robincoxe/kegboard/hw/BeagleBeer/BeagleBeer-FAB/BeagleBeer_v2_BOM.txt

Partlist exported from c:/close-haul/github/kegboard/hw/BeagleBeer/BeagleBeer.sch at 4/12/2013 11:06:30 PM

Part         Value                        Device                       Package               Description                                        TP_SIGNAL_NAME
C1           0.1 uF                       CAP0805                      0805                  Capacitor                                                        
C2           0.1 uF                       CAP0805                      0805                  Capacitor                                                        
C3           0.1 uF                       CAP0805                      0805                  Capacitor                                                        
C4           0.1 uF                       CAP0805                      0805                  Capacitor                                                        
C5           0.1 uF                       CAP0805                      0805                  Capacitor                                                        
C6           0.1 uF                       CAP0805                      0805                  Capacitor                                                        
C7           0.1 uF                       CAP0805                      0805                  Capacitor                                                        
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
RJ1          RJ45-8PTH                    RJ45-8PTH                    RJ45-8                RJ45 Jack                                                        
RJ2          RJ45-8PTH                    RJ45-8PTH                    RJ45-8                RJ45 Jack                                                        
SG1          BUZZERPTH                    BUZZERPTH                    BUZZER-12MM           Buzzer 12mm                                                      
SW1                                       TAC_SWITCHPTH                TACTILE-PTH           Momentary Switch                                                 
TEST_A                                    JUMPER-2PTH                  1X02                  Jumper                                                           
TEST_B                                    JUMPER-2PTH                  1X02                  Jumper                                                           
TEST_C                                    JUMPER-2PTH                  1X02                  Jumper                                                           
TEST_D                                    JUMPER-2PTH                  1X02                  Jumper                                                           
TP2          TPTP18SQ                     TPTP18SQ                     TP18SQ                Test pad                                                         
U1           TEMPERATURE-SENSORUMAX8      TEMPERATURE-SENSORUMAX8      UMAX8                                                                                  
U2                                        TXB0108PWR                   TSSOP20               8-Bit Bi-Directional Level Shifter                               
U3                                        TXB0108PWR                   TSSOP20               8-Bit Bi-Directional Level Shifter                               
U4           CAT24C256WI-GT3              CAT24C256WI-GT3              SOIC127P600X175-8N                                                                     
U5           BEAGLEBONE_OUTLINEBEAGLEBEER BEAGLEBONE_OUTLINEBEAGLEBEER BEAGLEBEER_SHIELD     Should match A3 pinout - but not completely tested
