robincoxe/kegboard/hw/BeagleBeer/BeagleBeer.pdf

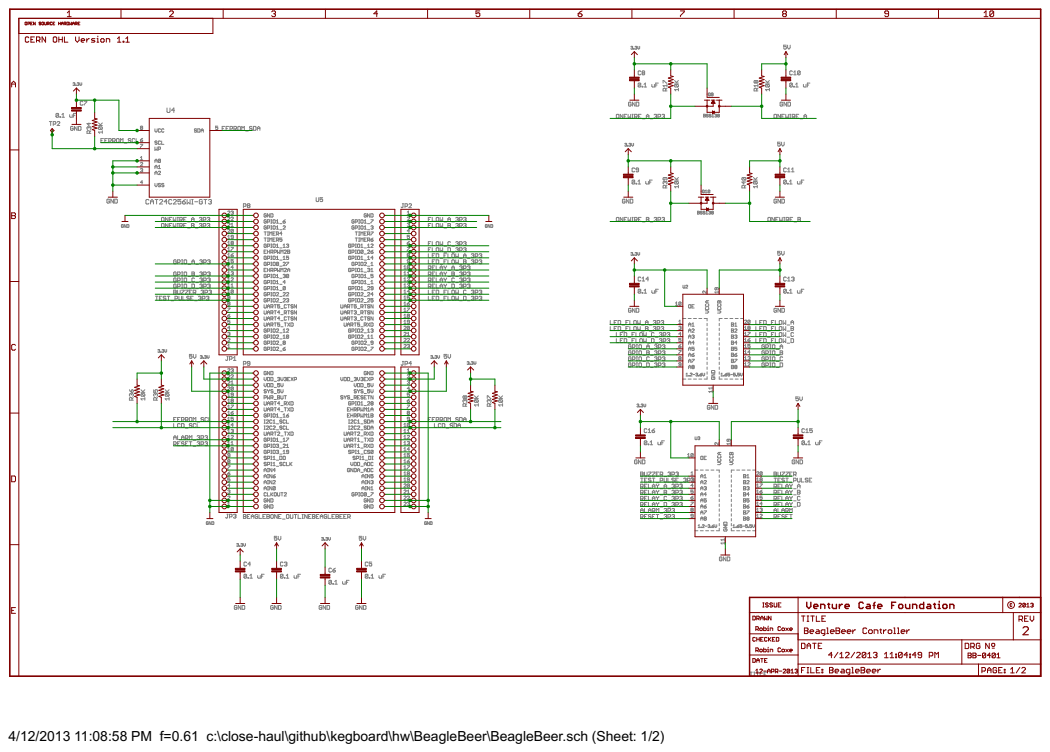
[picture p1: page 1]

4/12/2013 11:08:58 PM f=0.61 c:\close-haul\github\kegboard\hw\BeagleBeer\BeagleBeer.sch (Sheet: 1/2)

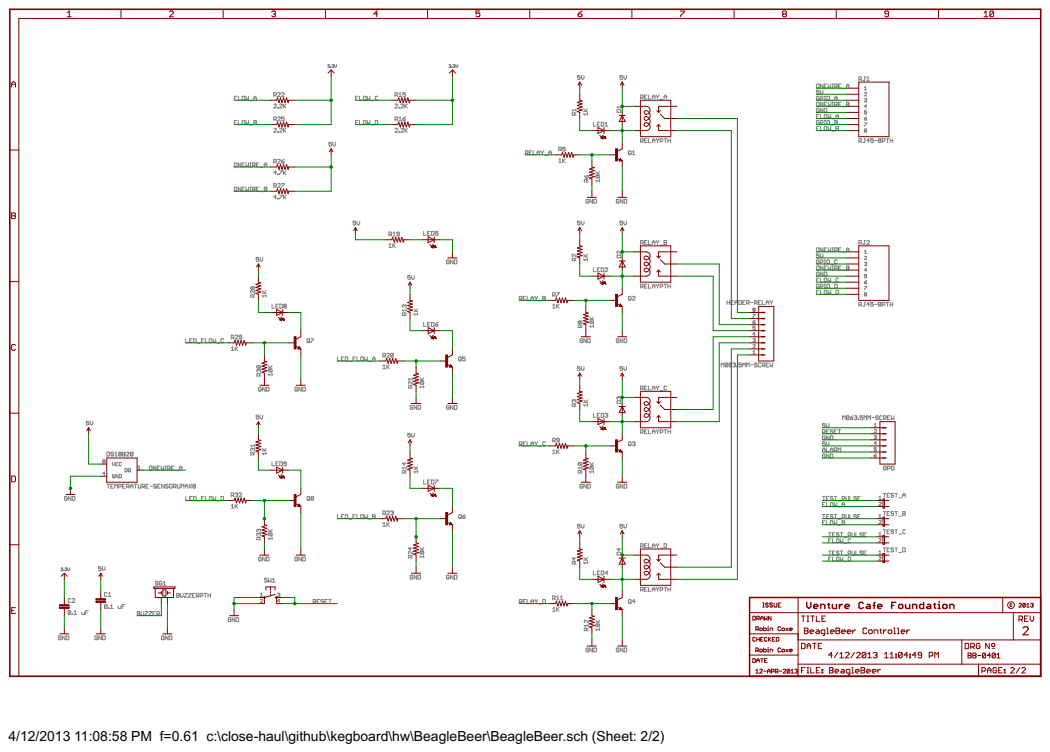
[picture p2: page 2]

4/12/2013 11:08:58 PM f=0.61 c:\close-haul\github\kegboard\hw\BeagleBeer\BeagleBeer.sch (Sheet: 2/2)
