robincoxe/kegboard/(list of files, drawings)

Other design files:
hw/BeagleBeer/BeagleBeer.dsn
hw/kegboard-coaster/kegboard-coaster-v2/kegboard-coaster.dsn
