robincoxe/kegboard/hw/kegboard-mini/kegboard-mini.brd

## EAGLE design hw/kegboard-mini/kegboard-mini.brd (2014-03-22)

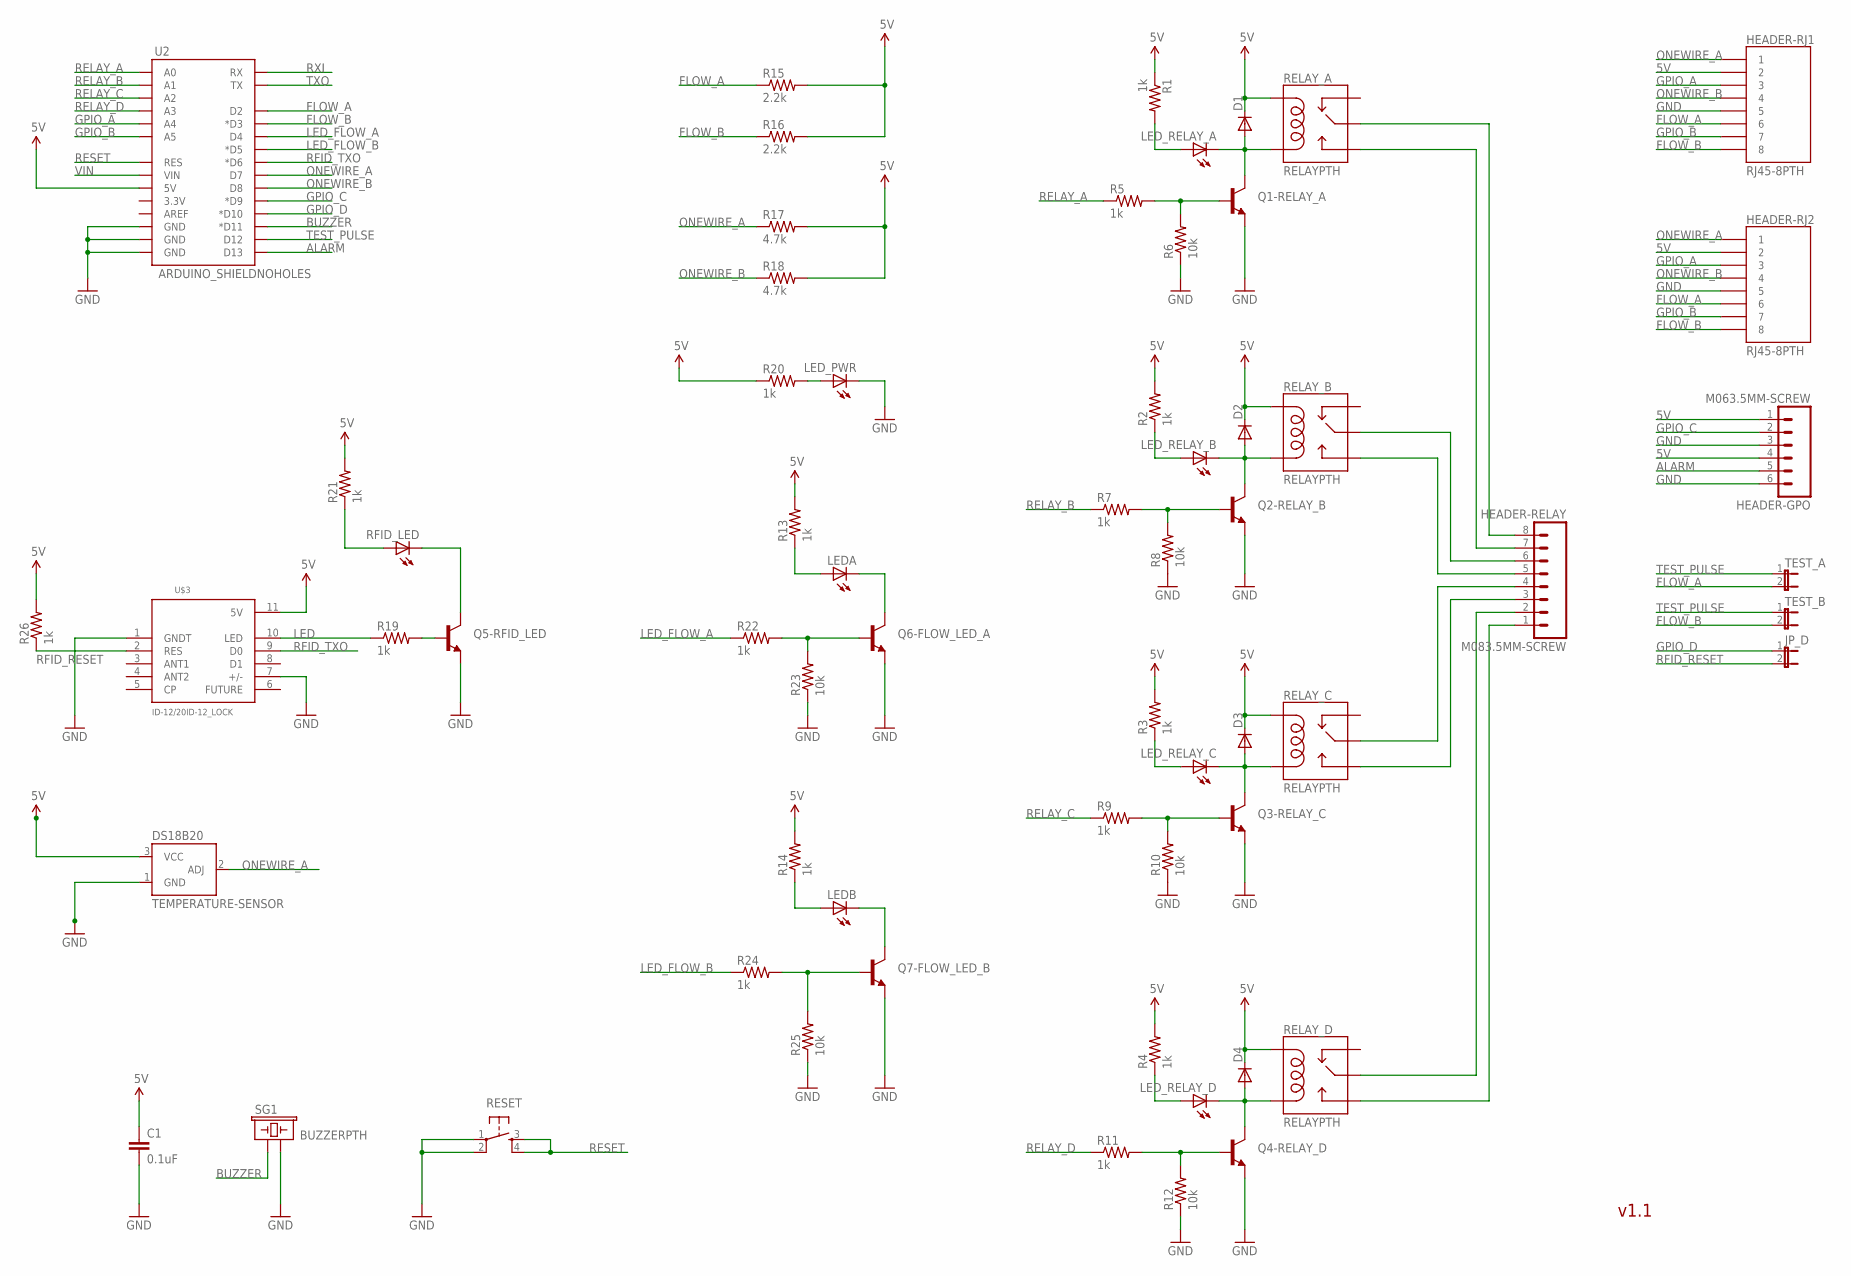
[picture p3: schematic kegboard-mini.sch]

Parts:
C1: 0.1uF; CAP-PTH-SMALL
D1, D2, D3, D4: DIODE1N4148; DIODE-1N4148
DS18B20: TEMPERATURE-SENSOR; TO-92
HEADER-GPO: M063.5MM-SCREW; SCREWTERMINAL-3.5MM-6
HEADER-RELAY: M083.5MM-SCREW; SCREWTERMINAL-3.5MM-8
HEADER-RJ1, HEADER-RJ2: RJ45-8PTH; RJ45-8
JP_D: JUMPER-2PTH; 1X02
LEDA: LED3MM
LEDB: LED3MM
LED_PWR: LED3MM
LED_RELAY_A: LED3MM
LED_RELAY_B: LED3MM
LED_RELAY_C: LED3MM
LED_RELAY_D: LED3MM
Q1-RELAY_A, Q2-RELAY_B, Q3-RELAY_C, Q4-RELAY_D, Q5-RFID_LED, Q6-FLOW_LED_A, Q7-FLOW_LED_B: TRANSISTOR_NPNTO92; TO-92
R1, R2, R3, R4, R5, R7, R9, R11, R13, R14, R19, R20, R21, R22, R24, R26: 1k; AXIAL-0.3
R6, R8, R10, R12, R23, R25: 10k; AXIAL-0.3
R15, R16: 2.2k; AXIAL-0.3
R17, R18: 4.7k; AXIAL-0.3
RELAY_A: RELAYPTH; RELAY-G5Q
RELAY_B: RELAYPTH; RELAY-G5Q
RELAY_C: RELAYPTH; RELAY-G5Q
RELAY_D: RELAYPTH; RELAY-G5Q
RESET: TAC_SWITCHPTH; TACTILE-PTH
RFID_LED: LED3MM
SG1: BUZZERPTH; BUZZER-12MM
TEST_A: JUMPER-2PTH; 1X02
TEST_B: JUMPER-2PTH; 1X02
U2: ARDUINO_SHIELDNOHOLES; DUEMILANOVE_SHIELD_NOHOLES
U$3: ID-12/20ID-12_LOCK; ID-12_LOCK

Connections:
5V: C1.1, D1.C, D2.C, D3.C, D4.C, DS18B20.3 (VCC), HEADER-GPO.1, HEADER-GPO.4, HEADER-RJ1.2, HEADER-RJ2.2, R1.P$1 (1), R2.P$2 (2), R3.P$2 (2), R4.P$2 (2), R13.P$2 (2), R14.P$2 (2), R15.P$2 (2), R16.P$2 (2), R17.P$2 (2), R18.P$2 (2), R20.P$1 (1), R21.P$2 (2), R26.P$2 (2), RELAY_A.5 (COIL1), RELAY_B.5 (COIL1), RELAY_C.5 (COIL1), RELAY_D.5 (COIL1), U2.5V, U$3.11 (5V)
ALARM: HEADER-GPO.5, U2.D13
BUZZER: SG1.+ (1), U2.D11 (*D11)
FLOW_A: HEADER-RJ1.6, HEADER-RJ2.6, R15.P$1 (1), TEST_A.2, U2.D2
FLOW_B: HEADER-RJ1.8, HEADER-RJ2.8, R16.P$1 (1), TEST_B.2, U2.D3 (*D3)
GND: C1.2, DS18B20.1 (GND), HEADER-GPO.3, HEADER-GPO.6, HEADER-RJ1.5, HEADER-RJ2.5, LED_PWR.K (C), Q1-RELAY_A.1 (E), Q2-RELAY_B.1 (E), Q3-RELAY_C.1 (E), Q4-RELAY_D.1 (E), Q5-RFID_LED.1 (E), Q6-FLOW_LED_A.1 (E), Q7-FLOW_LED_B.1 (E), R6.P$1 (1), R8.P$1 (1), R10.P$1 (1), R12.P$1 (1), R23.P$1 (1), R25.P$1 (1), RESET.1, RESET.2, SG1.- (2), U2.GND@0 (GND), U2.GND@1 (GND), U2.GND@2 (GND), U$3.1 (GNDT), U$3.7 (+/-)
GPIO_A: HEADER-RJ1.3, HEADER-RJ2.3, U2.A4
GPIO_B: HEADER-RJ1.7, HEADER-RJ2.7, U2.A5
GPIO_C: HEADER-GPO.2, U2.D9 (*D9)
GPIO_D: JP_D.1, U2.D10 (*D10)
LED: R19.P$1 (1), U$3.10 (LED)
LED_FLOW_A: R22.P$1 (1), U2.D4
LED_FLOW_B: R24.P$1 (1), U2.D5 (*D5)
unnamed: LED_RELAY_A.A, R1.P$2 (2)
unnamed: Q2-RELAY_B.2 (B), R7.P$2 (2), R8.P$2 (2)
unnamed: Q1-RELAY_A.2 (B), R5.P$2 (2), R6.P$2 (2)
unnamed: Q3-RELAY_C.2 (B), R9.P$2 (2), R10.P$2 (2)
unnamed: LED_RELAY_C.A, R3.P$1 (1)
unnamed: Q4-RELAY_D.2 (B), R11.P$2 (2), R12.P$2 (2)
unnamed: LED_RELAY_B.A, R2.P$1 (1)
unnamed: LEDB.K (C), Q7-FLOW_LED_B.3 (C)
unnamed: LEDA.K (C), Q6-FLOW_LED_A.3 (C)
unnamed: D1.A, LED_RELAY_A.K (C), Q1-RELAY_A.3 (C), RELAY_A.1 (COIL2)
unnamed: LED_RELAY_D.A, R4.P$1 (1)
unnamed: D2.A, LED_RELAY_B.K (C), Q2-RELAY_B.3 (C), RELAY_B.1 (COIL2)
unnamed: LED_PWR.A, R20.P$2 (2)
unnamed: D3.A, LED_RELAY_C.K (C), Q3-RELAY_C.3 (C), RELAY_C.1 (COIL2)
unnamed: HEADER-RELAY.8, RELAY_A.2 (MAIN)
unnamed: D4.A, LED_RELAY_D.K (C), Q4-RELAY_D.3 (C), RELAY_D.1 (COIL2)
unnamed: Q5-RFID_LED.2 (B), R19.P$2 (2)
unnamed: R21.P$1 (1), RFID_LED.A
unnamed: Q5-RFID_LED.3 (C), RFID_LED.K (C)
unnamed: HEADER-RELAY.7, RELAY_A.3 (NO)
unnamed: HEADER-RELAY.6, RELAY_B.2 (MAIN)
unnamed: HEADER-RELAY.5, RELAY_B.3 (NO)
unnamed: HEADER-RELAY.4, RELAY_C.2 (MAIN)
unnamed: LEDA.A, R13.P$1 (1)
unnamed: HEADER-RELAY.3, RELAY_C.3 (NO)
unnamed: HEADER-RELAY.2, RELAY_D.2 (MAIN)
unnamed: HEADER-RELAY.1, RELAY_D.3 (NO)
unnamed: LEDB.A, R14.P$1 (1)
unnamed: Q6-FLOW_LED_A.2 (B), R22.P$2 (2), R23.P$2 (2)
unnamed: Q7-FLOW_LED_B.2 (B), R24.P$2 (2), R25.P$2 (2)
ONEWIRE_A: DS18B20.2 (ADJ), HEADER-RJ1.1, HEADER-RJ2.1, R17.P$1 (1), U2.D7
ONEWIRE_B: HEADER-RJ1.4, HEADER-RJ2.4, R18.P$1 (1), U2.D8
RELAY_A: R5.P$1 (1), U2.A0
RELAY_B: R7.P$1 (1), U2.A1
RELAY_C: R9.P$1 (1), U2.A2
RELAY_D: R11.P$1 (1), U2.A3
RESET: RESET.3, RESET.4, U2.RES
RFID_RESET: JP_D.2, R26.P$1 (1), U$3.2 (RES)
RFID_TXO: U2.D6 (*D6), U$3.9 (D0)
RXI: U2.RX
TEST_PULSE: TEST_A.1, TEST_B.1, U2.D12
TXO: U2.TX
VIN: U2.VIN

Notes on the sheet:
v1.1

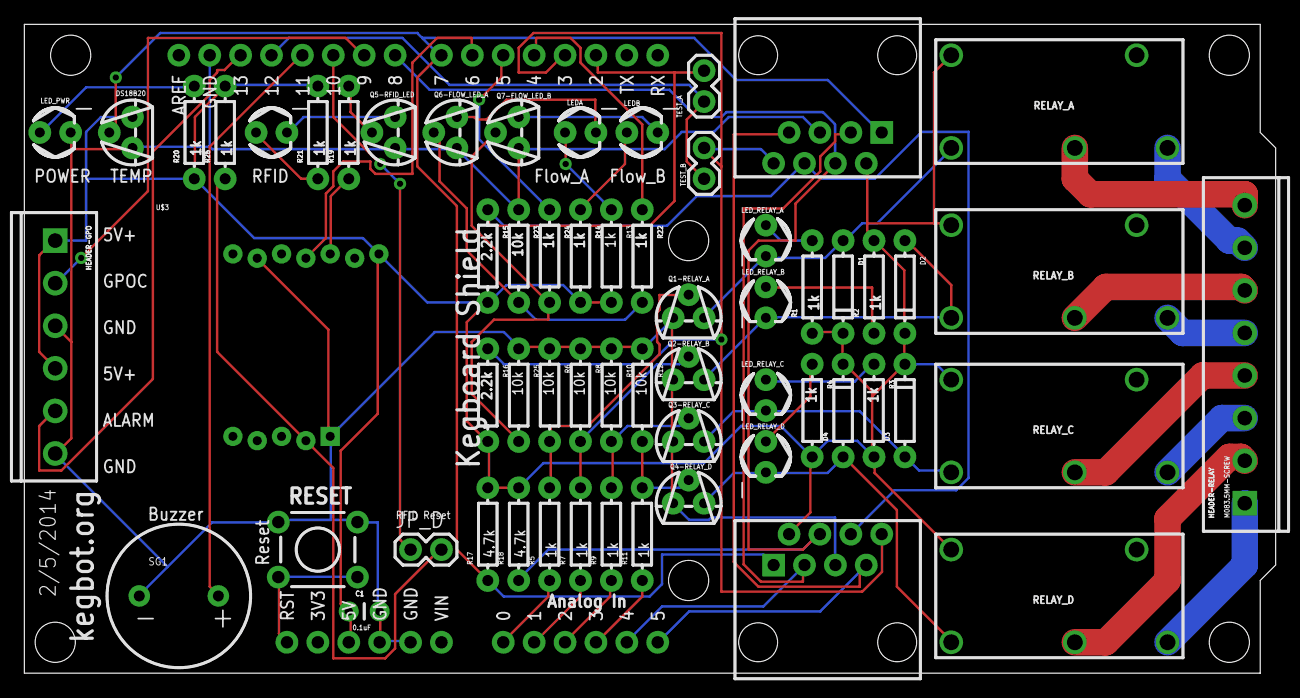
[picture p4: board kegboard-mini.brd from above]

Board: 2 copper layers, 102.9 x 53.3 mm, 68 parts (0 on the bottom side), 53 nets.

Other parts of the board:
JP1, JP2, JP3, JP4, JP5, JP6: STAND-OFF
