robincoxe/kegboard/hw/kegboard-coaster-alt/kegboard-coaster-alt.brd

## EAGLE design hw/kegboard-coaster-alt/kegboard-coaster-alt.brd (2013-07-20)

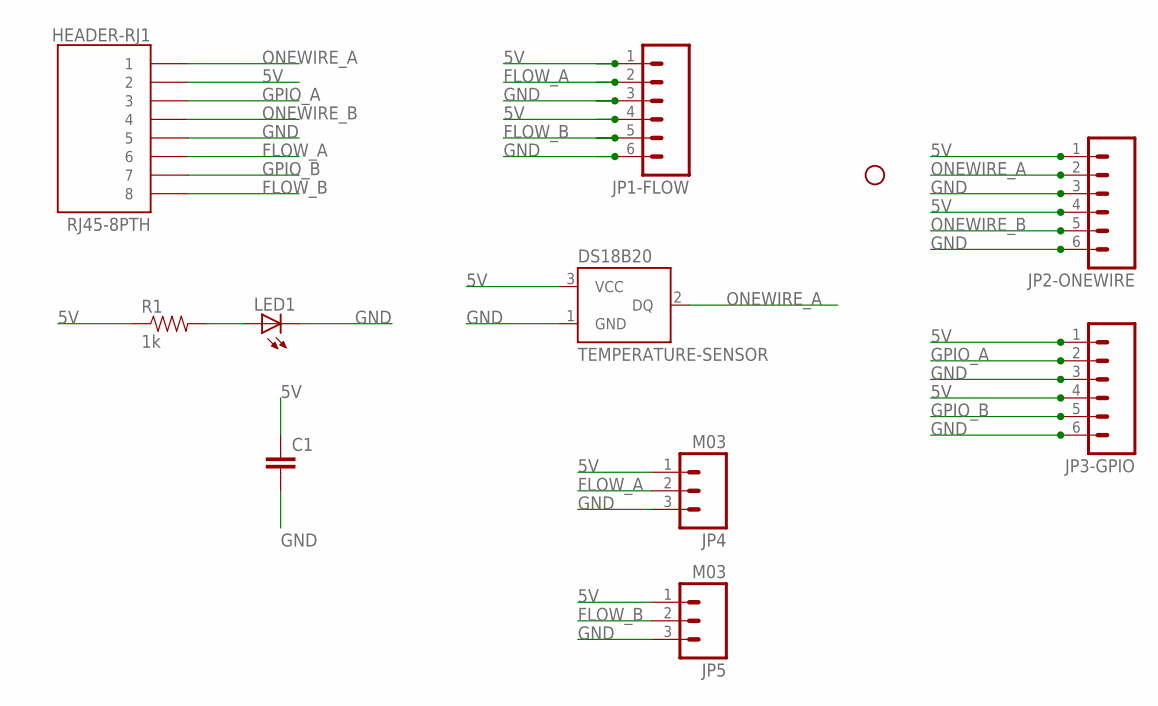
[picture p5: schematic kegboard-coaster-alt.sch]

Parts:
C1: CAPPTH2; CAP-PTH-SMALL2
HEADER-RJ1: RJ45-8PTH; RJ45-8
JP1-FLOW, JP2-ONEWIRE, JP3-GPIO: M063.5MM-6; SCREWTERMINAL-3.5MM-6
JP2: STAND-OFF
JP4, JP5: M03; 53324-0360
LED1: LED3MM
R1: 1k; AXIAL-0.3
U$1: TEMPERATURE-SENSOR; TO-92

Connections:
5V: C1.1, HEADER-RJ1.2, JP1-FLOW.1, JP1-FLOW.4, JP2-ONEWIRE.1, JP2-ONEWIRE.4, JP3-GPIO.1, JP3-GPIO.4, JP4.1, JP5.1, R1.P$1 (1), U$1.3 (VCC)
FLOW_A: HEADER-RJ1.6, JP1-FLOW.2, JP4.2
FLOW_B: HEADER-RJ1.8, JP1-FLOW.5, JP5.2
GND: C1.2, HEADER-RJ1.5, JP1-FLOW.3, JP1-FLOW.6, JP2-ONEWIRE.3, JP2-ONEWIRE.6, JP3-GPIO.3, JP3-GPIO.6, JP4.3, JP5.3, LED1.K (C), U$1.1 (GND)
GPIO_A: HEADER-RJ1.3, JP3-GPIO.2
GPIO_B: HEADER-RJ1.7, JP3-GPIO.5
unnamed: LED1.A, R1.P$2 (2)
ONEWIRE_A: HEADER-RJ1.1, JP2-ONEWIRE.2, U$1.2 (DQ)
ONEWIRE_B: HEADER-RJ1.4, JP2-ONEWIRE.5

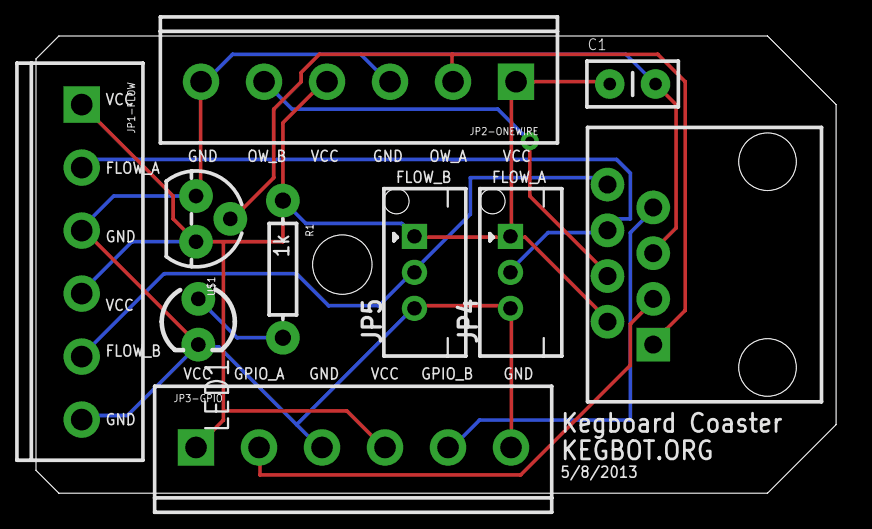
[picture p6: board kegboard-coaster-alt.brd from above]

Board: 2 copper layers, 44.5 x 25.4 mm, 11 parts (0 on the bottom side), 9 nets.
