robincoxe/kegboard/hw/BeagleBeer/BeagleBeer.brd

## EAGLE design hw/BeagleBeer/BeagleBeer.brd (2013-05-08)

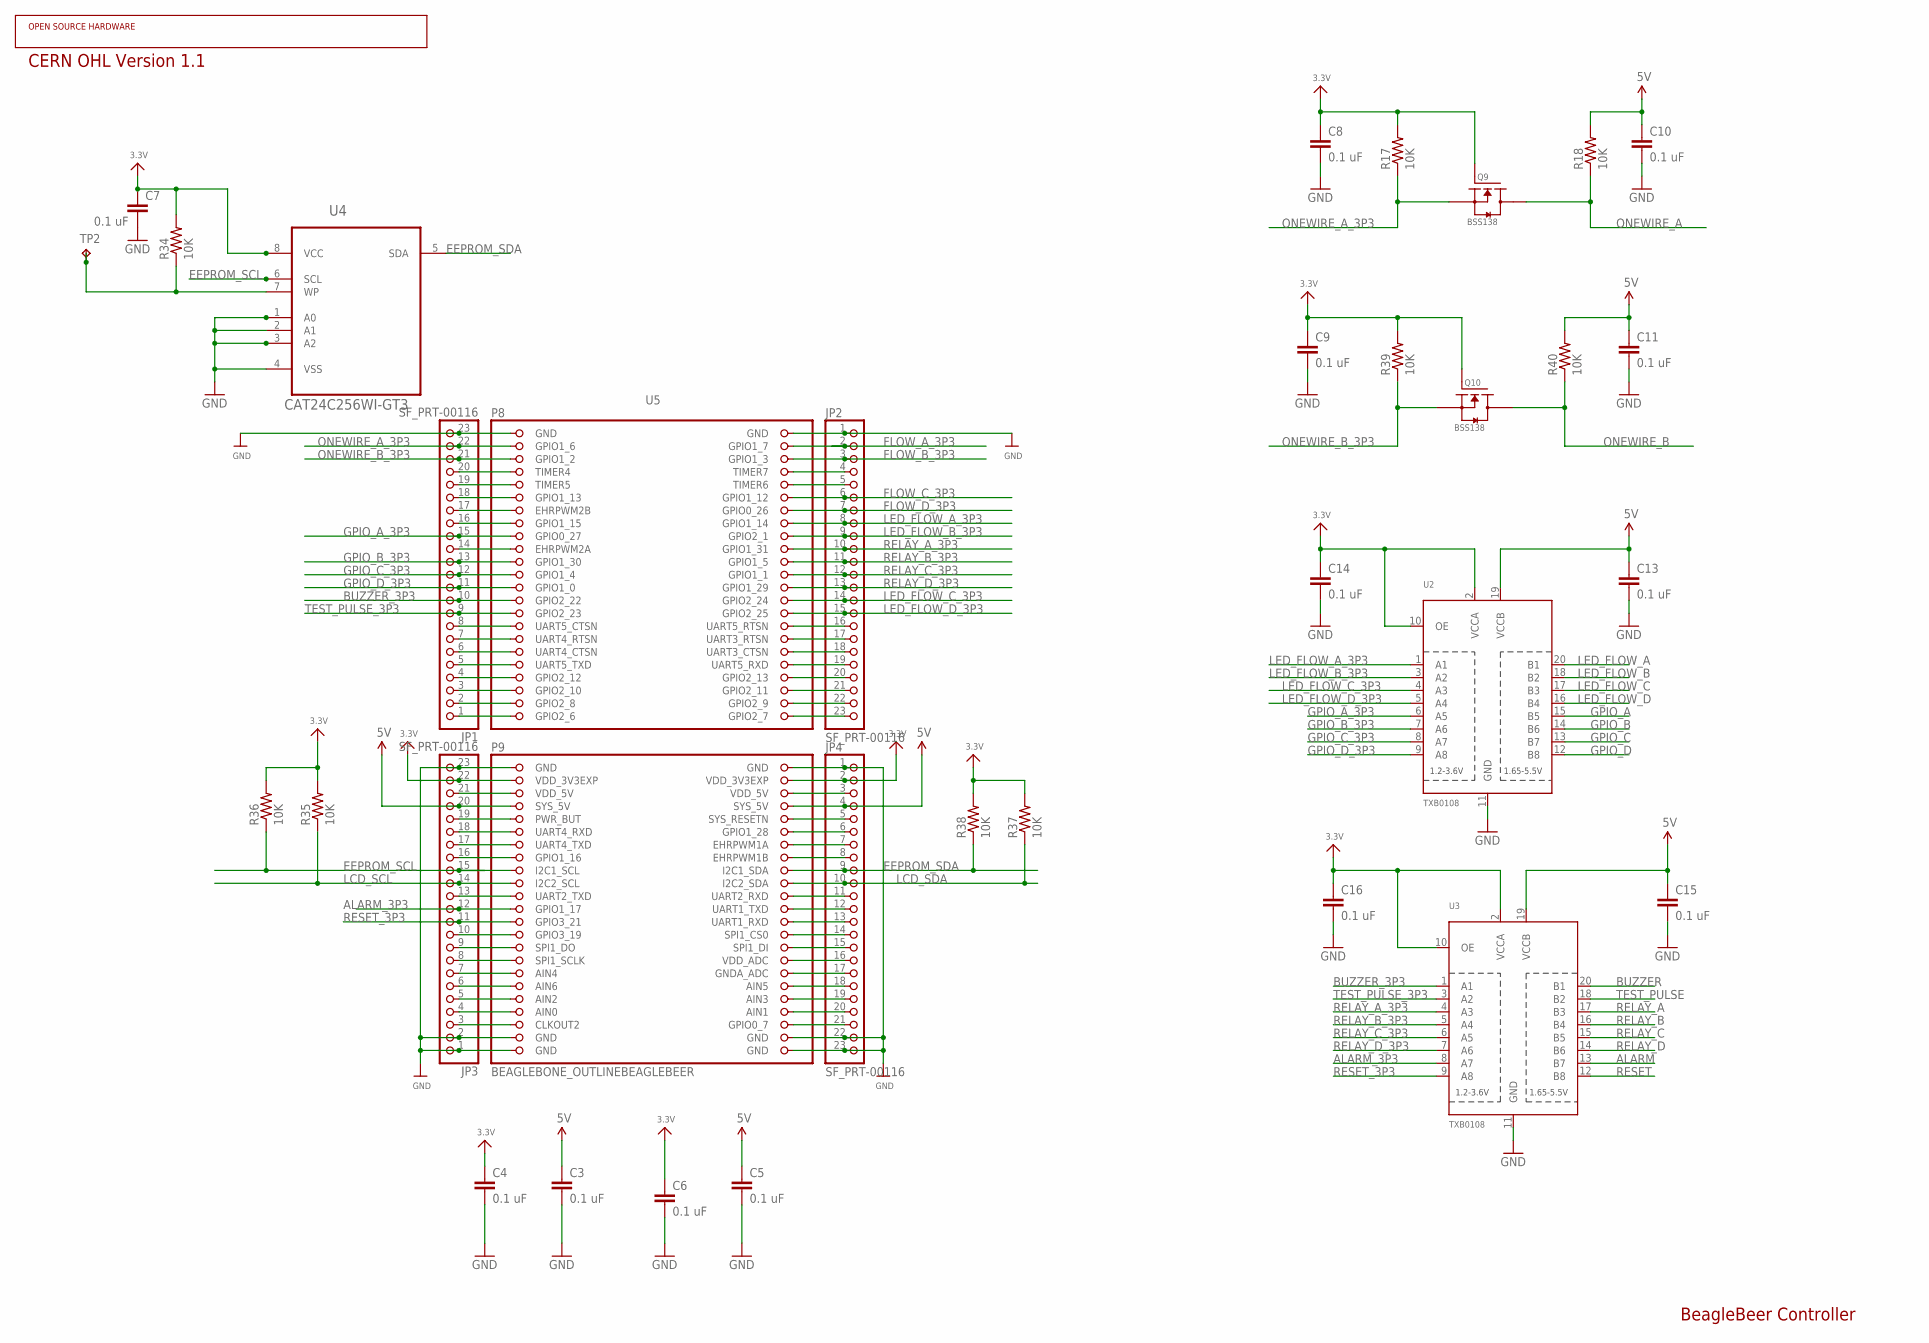
[picture p7: schematic BeagleBeer.sch, sheet 1]

Parts:
C3, C4, C5, C6, C7, C8, C9, C10, C11, C13, C14, C15, C16: 0.1 uF; 0805
JP1, JP2, JP3, JP4: SF_PRT-00116; 1X23_ROUND_70MIL
Q9, Q10: BSS138; SOT323
R17, R18, R34, R35, R36, R37, R38, R39, R40: 10K; 0805
TP2: TPTP18SQ; TP18SQ
U2, U3: TXB0108; TSSOP20
U4: CAT24C256WI-GT3; SOIC127P600X175-8N
U5: BEAGLEBONE_OUTLINEBEAGLEBEER; BEAGLEBEER_SHIELD

Connections:
3.3V: C4.1, C6.1, C7.1, C8.1, C9.1, C14.1, C16.1, JP3.22, JP4.2, Q9.1 (G), Q10.1 (G), R17.2, R34.2, R35.2, R36.2, R37.2, R38.2, R39.2, U2.2 (VCCA), U2.10 (OE), U3.2 (VCCA), U3.10 (OE), U4.8 (VCC), U5.49 (VDD_3V3EXP), U5.50 (VDD_3V3EXP); also elsewhere on the board
5V: C3.1, C5.1, C10.1, C11.1, C13.1, C15.1, JP3.20, JP4.4, R18.2, R40.2, U2.19 (VCCB), U3.19 (VCCB), U5.53 (SYS_5V), U5.54 (SYS_5V); also elsewhere on the board
ALARM: U3.13 (B7); also elsewhere on the board
ALARM_3P3: JP3.12, U3.8 (A7), U5.69 (GPIO1_17)
BUZZER: U3.20 (B1); also elsewhere on the board
BUZZER_3P3: JP1.10, U3.1 (A1), U5.27 (GPIO2_22)
EEPROM_SCL: JP3.15, R36.1, U4.6 (SCL), U5.63 (I2C1_SCL)
EEPROM_SDA: JP4.9, R38.1, U4.5 (SDA), U5.64 (I2C1_SDA)
FLOW_A_3P3: JP2.2, U5.4 (GPIO1_7)
FLOW_B_3P3: JP2.3, U5.6 (GPIO1_3)
FLOW_C_3P3: JP2.6, U5.12 (GPIO1_12)
FLOW_D_3P3: JP2.7, U5.14 (GPIO0_26)
GND: C3.2, C4.2, C5.2, C6.2, C7.2, C8.2, C9.2, C10.2, C11.2, C13.2, C14.2, C15.2, C16.2, JP1.23, JP2.1, JP3.1, JP3.2, JP3.23, JP4.1, JP4.22, JP4.23, U2.11 (GND), U3.11 (GND), U4.1 (A0), U4.2 (A1), U4.3 (A2), U4.4 (VSS), U5.1 (GND), U5.2 (GND), U5.47 (GND), U5.48 (GND), U5.89 (GND), U5.90 (GND), U5.91 (GND), U5.92 (GND); also elsewhere on the board
GPIO_A: U2.15 (B5); also elsewhere on the board
GPIO_A_3P3: JP1.15, U2.6 (A5), U5.17 (GPIO0_27)
GPIO_B: U2.14 (B6); also elsewhere on the board
GPIO_B_3P3: JP1.13, U2.7 (A6), U5.21 (GPIO1_30)
GPIO_C: U2.13 (B7); also elsewhere on the board
GPIO_C_3P3: JP1.12, U2.8 (A7), U5.23 (GPIO1_4)
GPIO_D: U2.12 (B8); also elsewhere on the board
GPIO_D_3P3: JP1.11, U2.9 (A8), U5.25 (GPIO1_0)
LCD_SCL: JP3.14, R35.1, U5.65 (I2C2_SCL)
LCD_SDA: JP4.10, R37.1, U5.66 (I2C2_SDA)
LED_FLOW_A: U2.20 (B1); also elsewhere on the board
LED_FLOW_A_3P3: JP2.8, U2.1 (A1), U5.16 (GPIO1_14)
LED_FLOW_B: U2.18 (B2); also elsewhere on the board
LED_FLOW_B_3P3: JP2.9, U2.3 (A2), U5.18 (GPIO2_1)
LED_FLOW_C: U2.17 (B3); also elsewhere on the board
LED_FLOW_C_3P3: JP2.14, U2.4 (A3), U5.28 (GPIO2_24)
LED_FLOW_D: U2.16 (B4); also elsewhere on the board
LED_FLOW_D_3P3: JP2.15, U2.5 (A4), U5.30 (GPIO2_25)
unnamed: JP1.2, U5.43 (GPIO2_8)
unnamed: JP1.1, U5.45 (GPIO2_6)
unnamed: JP1.20, U5.7 (TIMER4)
unnamed: JP1.19, U5.9 (TIMER5)
unnamed: JP2.16, U5.32 (UART5_RTSN)
unnamed: JP1.17, U5.13 (EHRPWM2B)
unnamed: JP2.17, U5.34 (UART3_RTSN)
unnamed: JP2.18, U5.36 (UART3_CTSN)
unnamed: JP1.14, U5.19 (EHRPWM2A)
unnamed: JP2.19, U5.38 (UART5_RXD)
unnamed: JP2.20, U5.40 (GPIO2_13)
unnamed: JP2.21, U5.42 (GPIO2_11)
unnamed: JP2.22, U5.44 (GPIO2_9)
unnamed: JP2.23, U5.46 (GPIO2_7)
unnamed: JP1.8, U5.31 (UART5_CTSN)
unnamed: JP1.7, U5.33 (UART4_RTSN)
unnamed: JP1.6, U5.35 (UART4_CTSN)
unnamed: JP1.5, U5.37 (UART5_TXD)
unnamed: JP1.4, U5.39 (GPIO2_12)
unnamed: JP1.3, U5.41 (GPIO2_10)
unnamed: JP2.4, U5.8 (TIMER7)
unnamed: JP2.5, U5.10 (TIMER6)
unnamed: JP3.21, U5.51 (VDD_5V)
unnamed: JP3.19, U5.55 (PWR_BUT)
unnamed: JP3.18, U5.57 (UART4_RXD)
unnamed: JP3.17, U5.59 (UART4_TXD)
unnamed: JP3.16, U5.61 (GPIO1_16)
unnamed: JP3.13, U5.67 (UART2_TXD)
unnamed: JP3.10, U5.73 (GPIO3_19)
unnamed: JP3.9, U5.75 (SPI1_DO)
unnamed: JP3.8, U5.77 (SPI1_SCLK)
unnamed: JP3.7, U5.79 (AIN4)
unnamed: JP3.6, U5.81 (AIN6)
unnamed: JP3.5, U5.83 (AIN2)
unnamed: JP3.4, U5.85 (AIN0)
unnamed: JP3.3, U5.87 (CLKOUT2)
unnamed: JP4.21, U5.88 (GPIO0_7)
unnamed: JP4.3, U5.52 (VDD_5V)
unnamed: JP4.5, U5.56 (SYS_RESETN)
unnamed: JP4.6, U5.58 (GPIO1_28)
unnamed: JP4.7, U5.60 (EHRPWM1A)
unnamed: JP4.8, U5.62 (EHRPWM1B)
unnamed: JP4.11, U5.68 (UART2_RXD)
unnamed: JP4.12, U5.70 (UART1_TXD)
unnamed: JP4.13, U5.72 (UART1_RXD)
unnamed: JP4.14, U5.74 (SPI1_CS0)
unnamed: JP4.15, U5.76 (SPI1_DI)
unnamed: JP4.16, U5.78 (VDD_ADC)
unnamed: JP4.17, U5.80 (GNDA_ADC)
unnamed: JP4.18, U5.82 (AIN5)
unnamed: JP4.19, U5.84 (AIN3)
unnamed: JP4.20, U5.86 (AIN1)
unnamed: R34.1, TP2.TP, U4.7 (WP)
ONEWIRE_A: Q9.3 (D1), R18.1; also elsewhere on the board
ONEWIRE_A_3P3: JP1.22, Q9.2 (S), R17.1, U5.3 (GPIO1_6)
ONEWIRE_B: Q10.3 (D1), R40.1; also elsewhere on the board
ONEWIRE_B_3P3: JP1.21, Q10.2 (S), R39.1, U5.5 (GPIO1_2)
ONEWIRE_C_3P3: JP1.18, U5.11 (GPIO1_13)
ONEWIRE_D_3P3: JP1.16, U5.15 (GPIO1_15)
RELAY_A: U3.17 (B3); also elsewhere on the board
RELAY_A_3P3: JP2.10, U3.4 (A3), U5.20 (GPIO1_31)
RELAY_B: U3.16 (B4); also elsewhere on the board
RELAY_B_3P3: JP2.11, U3.5 (A4), U5.22 (GPIO1_5)
RELAY_C: U3.15 (B5); also elsewhere on the board
RELAY_C_3P3: JP2.12, U3.6 (A5), U5.24 (GPIO1_1)
RELAY_D: U3.14 (B6); also elsewhere on the board
RELAY_D_3P3: JP2.13, U3.7 (A6), U5.26 (GPIO1_29)
RESET: U3.12 (B8); also elsewhere on the board
RESET_3P3: JP3.11, U3.9 (A8), U5.71 (GPIO3_21)
TEST_PULSE: U3.18 (B2); also elsewhere on the board
TEST_PULSE_3P3: JP1.9, U3.3 (A2), U5.29 (GPIO2_23)

Notes on the sheet:
BeagleBeer Controller

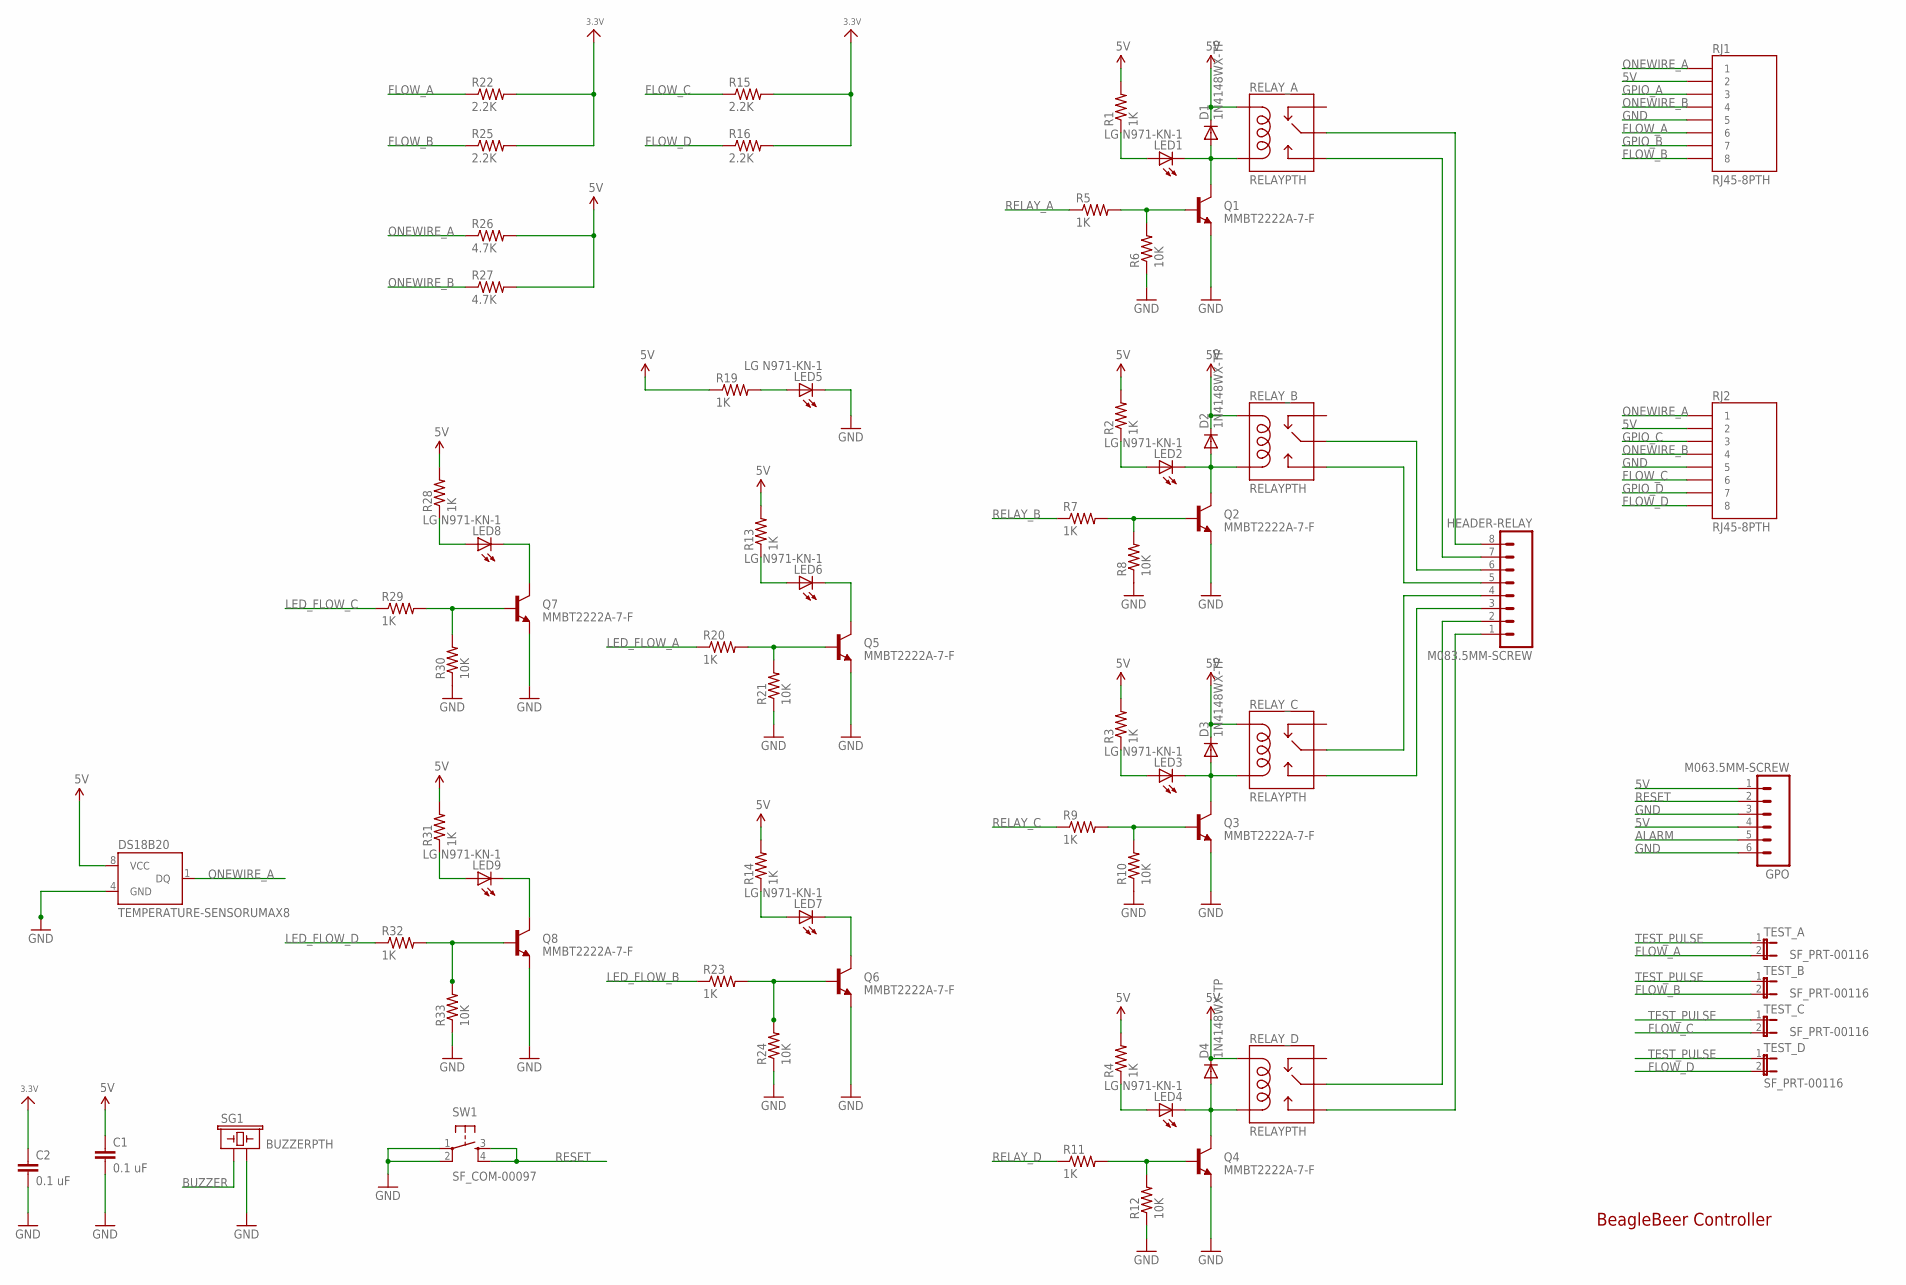
[picture p8: schematic BeagleBeer.sch, sheet 2]

Parts:
C1, C2: 0.1 uF; 0805
D1, D2, D3, D4: 1N4148WX-TP; SOD-323
GPO: M063.5MM-SCREW; SCREWTERMINAL-3.5MM-6
HEADER-RELAY: M083.5MM-SCREW; SCREWTERMINAL-3.5MM-8
LED1, LED2, LED3, LED4, LED5, LED6, LED7, LED8, LED9: LG N971-KN-1; LED-1206
Q1, Q2, Q3, Q4, Q5, Q6, Q7, Q8: MMBT2222A-7-F; SOT23-3
R1, R2, R3, R4, R5, R7, R9, R11, R13, R14, R19, R20, R23, R28, R29, R31, R32: 1K; 0805
R6, R8, R10, R12, R21, R24, R30, R33: 10K; 0805
R15, R16, R22, R25: 2.2K; 0805
R26, R27: 4.7K; 0805
RELAY_A: RELAYPTH; RELAY-G5Q
RELAY_B: RELAYPTH; RELAY-G5Q
RELAY_C: RELAYPTH; RELAY-G5Q
RELAY_D: RELAYPTH; RELAY-G5Q
RJ1, RJ2: RJ45-8PTH; RJ45-8
SG1: BUZZERPTH; BUZZER-12MM
SW1: SF_COM-00097; TACTILE-PTH
TEST_A: SF_PRT-00116; 1X02
TEST_B: SF_PRT-00116; 1X02
TEST_C: SF_PRT-00116; 1X02
TEST_D: SF_PRT-00116; 1X02
U1: TEMPERATURE-SENSORUMAX8; UMAX8

Connections:
3.3V: C2.1, R15.2, R16.2, R22.2, R25.2; also elsewhere on the board
5V: C1.1, D1.1 (C), D2.1 (C), D3.1 (C), D4.1 (C), GPO.1, GPO.4, R1.2, R2.2, R3.2, R4.2, R13.2, R14.2, R19.1, R26.2, R27.2, R28.2, R31.2, RELAY_A.5 (COIL1), RELAY_B.5 (COIL1), RELAY_C.5 (COIL1), RELAY_D.5 (COIL1), RJ1.2, RJ2.2, U1.8 (VCC); also elsewhere on the board
ALARM: GPO.5; also elsewhere on the board
BUZZER: SG1.+ (1); also elsewhere on the board
FLOW_A: R22.1, RJ1.6, TEST_A.2
FLOW_B: R25.1, RJ1.8, TEST_B.2
FLOW_C: R15.1, RJ2.6, TEST_C.2
FLOW_D: R16.1, RJ2.8, TEST_D.2
GND: C1.2, C2.2, GPO.3, GPO.6, LED5.C, Q1.2 (E), Q2.2 (E), Q3.2 (E), Q4.2 (E), Q5.2 (E), Q6.2 (E), Q7.2 (E), Q8.2 (E), R6.1, R8.1, R10.1, R12.1, R21.1, R24.1, R30.1, R33.1, RJ1.5, RJ2.5, SG1.- (2), SW1.1, SW1.2, U1.4 (GND); also elsewhere on the board
GPIO_A: RJ1.3; also elsewhere on the board
GPIO_B: RJ1.7; also elsewhere on the board
GPIO_C: RJ2.3; also elsewhere on the board
GPIO_D: RJ2.7; also elsewhere on the board
LED_FLOW_A: R20.1; also elsewhere on the board
LED_FLOW_B: R23.1; also elsewhere on the board
LED_FLOW_C: R29.1; also elsewhere on the board
LED_FLOW_D: R32.1; also elsewhere on the board
unnamed: LED8.C, Q7.3 (C)
unnamed: LED8.A, R28.1
unnamed: Q7.1 (B), R29.2, R30.2
unnamed: LED9.C, Q8.3 (C)
unnamed: D1.2 (A), LED1.C, Q1.3 (C), RELAY_A.1 (COIL2)
unnamed: D2.2 (A), LED2.C, Q2.3 (C), RELAY_B.1 (COIL2)
unnamed: D3.2 (A), LED3.C, Q3.3 (C), RELAY_C.1 (COIL2)
unnamed: D4.2 (A), LED4.C, Q4.3 (C), RELAY_D.1 (COIL2)
unnamed: Q1.1 (B), R5.2, R6.2
unnamed: Q2.1 (B), R7.2, R8.2
unnamed: Q3.1 (B), R9.2, R10.2
unnamed: Q4.1 (B), R11.2, R12.2
unnamed: LED5.A, R19.2
unnamed: HEADER-RELAY.8, RELAY_A.2 (MAIN)
unnamed: HEADER-RELAY.7, RELAY_A.3 (NO)
unnamed: HEADER-RELAY.6, RELAY_B.2 (MAIN)
unnamed: HEADER-RELAY.5, RELAY_B.3 (NO)
unnamed: LED9.A, R31.1
unnamed: Q8.1 (B), R32.2, R33.2
unnamed: HEADER-RELAY.4, RELAY_C.2 (MAIN)
unnamed: HEADER-RELAY.3, RELAY_C.3 (NO)
unnamed: HEADER-RELAY.2, RELAY_D.2 (MAIN)
unnamed: HEADER-RELAY.1, RELAY_D.3 (NO)
unnamed: LED1.A, R1.1
unnamed: LED2.A, R2.1
unnamed: LED3.A, R3.1
unnamed: LED4.A, R4.1
unnamed: LED6.C, Q5.3 (C)
unnamed: LED6.A, R13.1
unnamed: Q5.1 (B), R20.2, R21.2
unnamed: LED7.C, Q6.3 (C)
unnamed: LED7.A, R14.1
unnamed: Q6.1 (B), R23.2, R24.2
ONEWIRE_A: R26.1, RJ1.1, RJ2.1, U1.1 (DQ); also elsewhere on the board
ONEWIRE_B: R27.1, RJ1.4, RJ2.4; also elsewhere on the board
RELAY_A: R5.1; also elsewhere on the board
RELAY_B: R7.1; also elsewhere on the board
RELAY_C: R9.1; also elsewhere on the board
RELAY_D: R11.1; also elsewhere on the board
RESET: GPO.2, SW1.3, SW1.4; also elsewhere on the board
TEST_PULSE: TEST_A.1, TEST_B.1, TEST_C.1, TEST_D.1; also elsewhere on the board

Notes on the sheet:
BeagleBeer Controller

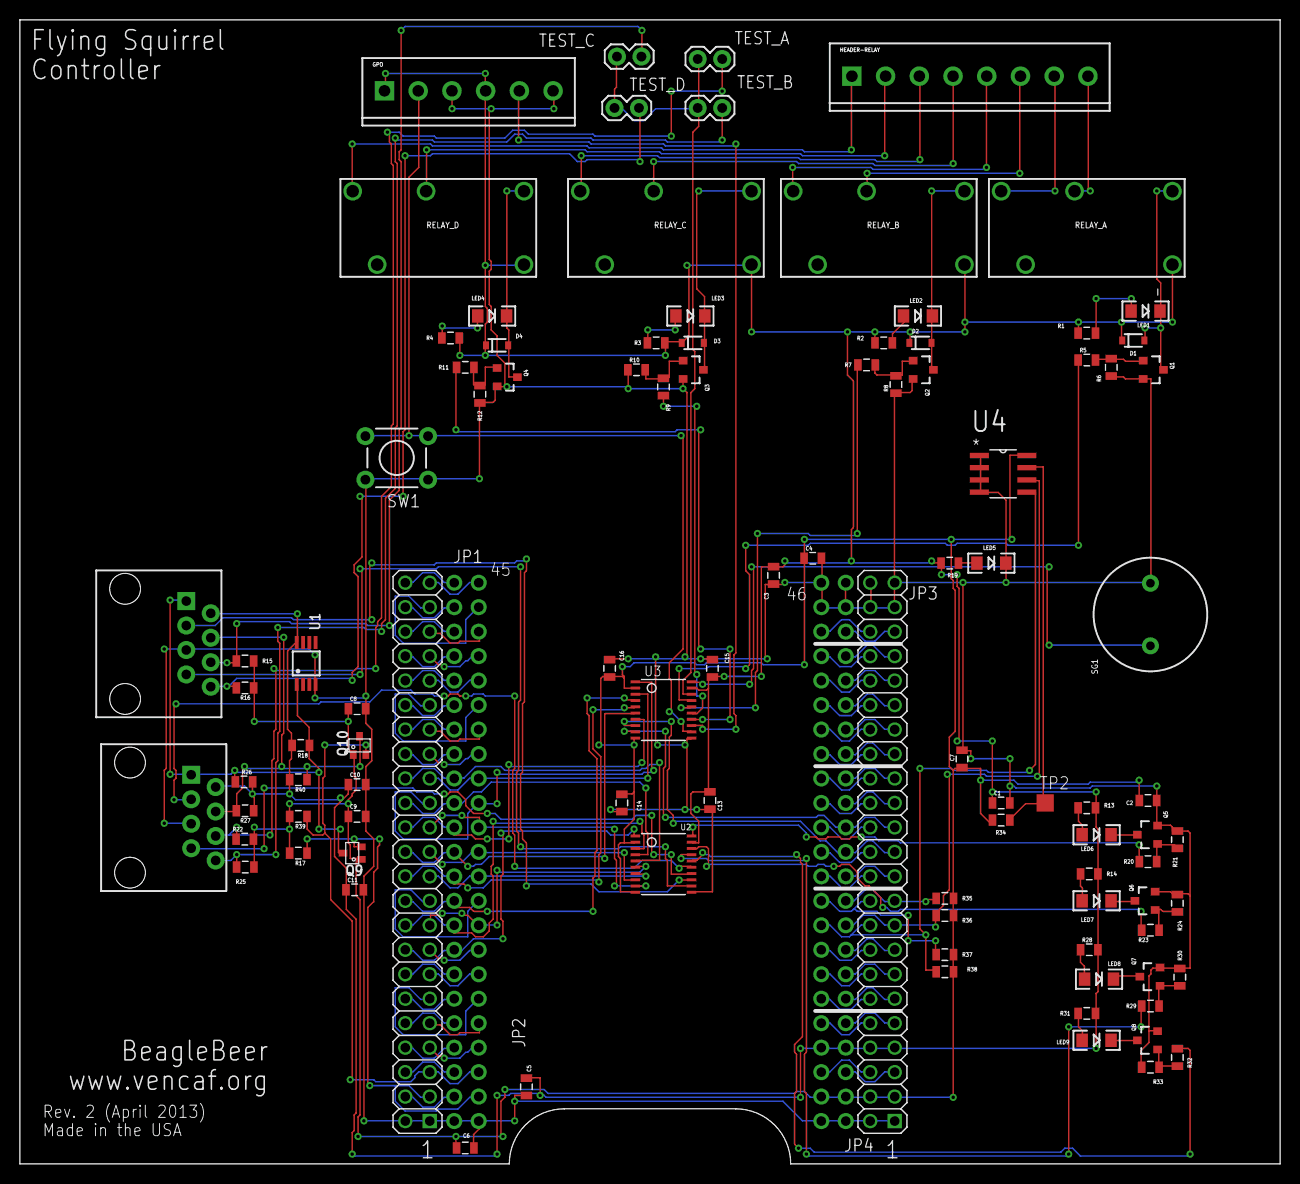
[picture p9: board BeagleBeer.brd from above]

Board: 2 copper layers, 130.8 x 118.7 mm, 102 parts (0 on the bottom side), 139 nets.
