robincoxe/kegboard/hw/kegboard-coaster/kegboard-coaster-v2/kegboard-coaster.brd

## EAGLE design hw/kegboard-coaster/kegboard-coaster-v2/kegboard-coaster.brd (2013-03-16)

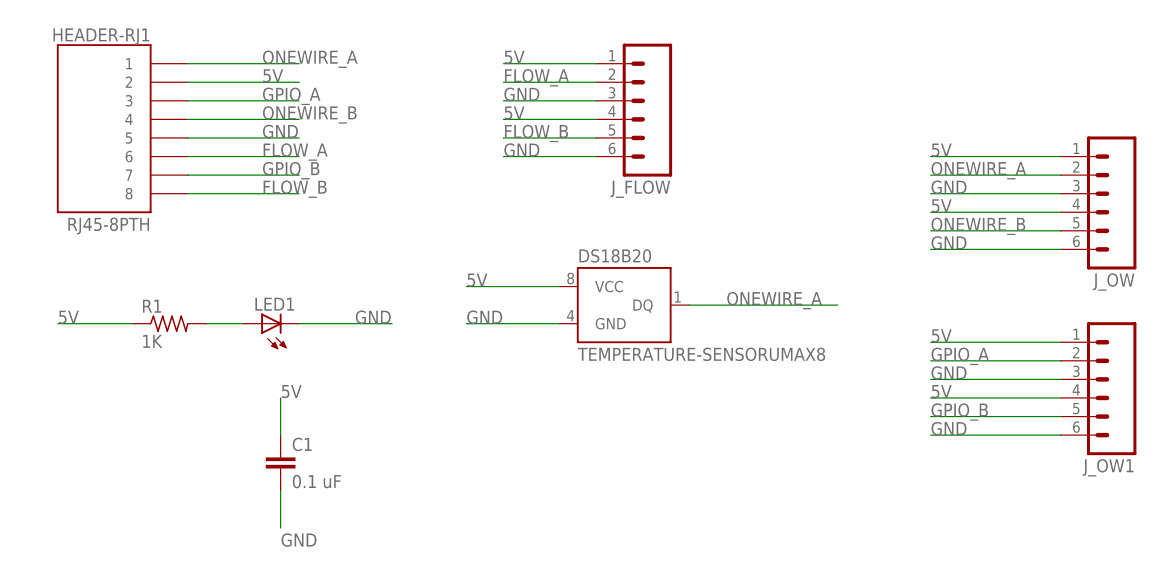
[picture p10: schematic kegboard-coaster.sch]

Parts:
C1: 0.1 uF; 0805
HEADER-RJ1: RJ45-8PTH; RJ45-8
J_FLOW: M06SIP; 1X06
J_OW, J_OW1: M06SIP; 1X06
LED1: LED-FKIT-1206; FKIT-LED-1206
R1: 1K; R0805
U$1: TEMPERATURE-SENSORUMAX8; UMAX8

Connections:
5V: C1.1, HEADER-RJ1.2, J_FLOW.1, J_FLOW.4, J_OW.1, J_OW.4, J_OW1.1, J_OW1.4, R1.1, U$1.8 (VCC)
FLOW_A: HEADER-RJ1.6, J_FLOW.2
FLOW_B: HEADER-RJ1.8, J_FLOW.5
GND: C1.2, HEADER-RJ1.5, J_FLOW.3, J_FLOW.6, J_OW.3, J_OW.6, J_OW1.3, J_OW1.6, LED1.C, U$1.4 (GND)
GPIO_A: HEADER-RJ1.3, J_OW1.2
GPIO_B: HEADER-RJ1.7, J_OW1.5
unnamed: LED1.A, R1.2
ONEWIRE_A: HEADER-RJ1.1, J_OW.2, U$1.1 (DQ)
ONEWIRE_B: HEADER-RJ1.4, J_OW.5

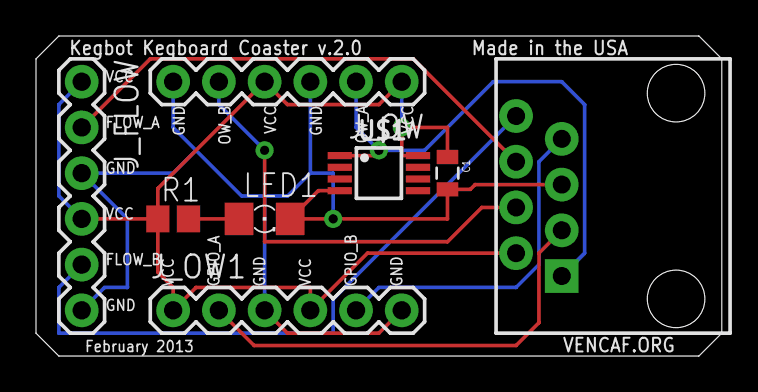
[picture p11: board kegboard-coaster.brd from above]

Board: 2 copper layers, 38.1 x 17.8 mm, 8 parts (0 on the bottom side), 9 nets.
