robincoxe/kegboard/(commit log)

2013-01-24 Modify Kegbot Kegboard Coaster to use SMD components (0805 R & C, 1206 LED)
    [kegboard-coaster.brd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]
2013-01-24 Change folder name to v2.
    [kegboard-coaster.brd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]
2013-01-24 Use Adafruit BeagleBone Proto Board as starting point for BeagleBeer cape.
    [Adafruit-BeagleBone-ProtoBoard-v0.1.brd, Adafruit-BeagleBone-ProtoBoard-v0.1.sch]
2013-01-25 Replace Temp Sensor with SMD package
    [kegboard-coaster.dsn, kegboard-coaster.sch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]
2013-01-25 Update BOM
    [kegboard-coaster_BOM.csv]
2013-01-25 Fix temp. sensor REFDES
    [kegboard-coaster.brd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]
2013-01-25 Move Gerbers to folder
    [kegboard-coaster.GBL, kegboard-coaster.GBO, kegboard-coaster.GBS, kegboard-coaster.GTL, kegboard-coaster.GTO, kegboard-coaster.GTP, kegboard-coaster.GTS]
2013-01-25 Fix Temp Sensor REFDES
    [kegboard-coaster_BOM.csv]
2013-01-26 Fix trace between resistor & LED
    [kegboard-coaster.brd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]
2013-02-07 Modify Kegbot Coaster silkscreen
    [Adafruit-BeagleBone-ProtoBoard-v0.1.brd, Adafruit-BeagleBone-ProtoBoard-v0.1.sch, BeagleBeer.brd, BeagleBeer.sch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]
2013-02-07 Modify silkscreen
2013-02-11 Route BeagleBeer Flying Squirrel Controller PCB.
    [BeagleBeer.brd, BeagleBeer.cfg, BeagleBeer.dsn, BeagleBeer.sch]
2013-02-11 Controller PCB layout.
2013-02-14 Run ERC on Controller and reroute.
    [BeagleBeer.brd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]
2013-02-14 Rename Gerber folders <project-name>-FAB
    [BeagleBeer_bom.csv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]
2013-02-14 Add board outline to CAM file/Gerber file sets for Sunstone Circuits.
    [BeagleBeer_bom.csv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]
2013-02-14 Clean up Gerber files. Generate XY parts placement files.
    [BeagleBeer.brd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]
2013-02-18 Add misc. SMD datasheets and master BOM.
    [BeerBeer_master_BOM_17feb13.xlsx]
2013-02-20 Rename master branch venturecafe
    [BeerBeer_master_BOM_17feb13.xlsx]
2013-03-02 update archive with as built files
    [BeagleBeer.sch]
2013-03-16 commit changes
    [BeagleBeer.brd, kegboard-coaster.brd]
2013-04-13 BeagleBeer v2
    [BeagleBeer.brd, BeagleBeer.cfg, BeagleBeer.dsn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]
2013-04-13 BeagleBeer v2 Run ERCs and DRCs
    [BeagleBeer.brd, BeagleBeer.cfg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]
2013-04-13 Remove redundant RJ45 connectors on BeagleBeer
    [BeagleBeer.brd, BeagleBeer.sch, BeagleBeer_centroid.csv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]
2014-03-22 Kegboard mini & beaglebeer Python
    [kegboard-mini.brd, kegboard-mini.sch]
