robincoxe/kegboard/(notices)

Notices in the files:
parts and their libraries:
SparkFun-LED: Licensing: CC v3.0 Share-Alike You are welcome to use this library for commercial purposes.
dframes: CERN OHL Version 1.1
